spencerh122/CMPE-3815---Microcontroller-Systems-Final-Project/Pictures/Version 2 Electronics Bay.jpeg

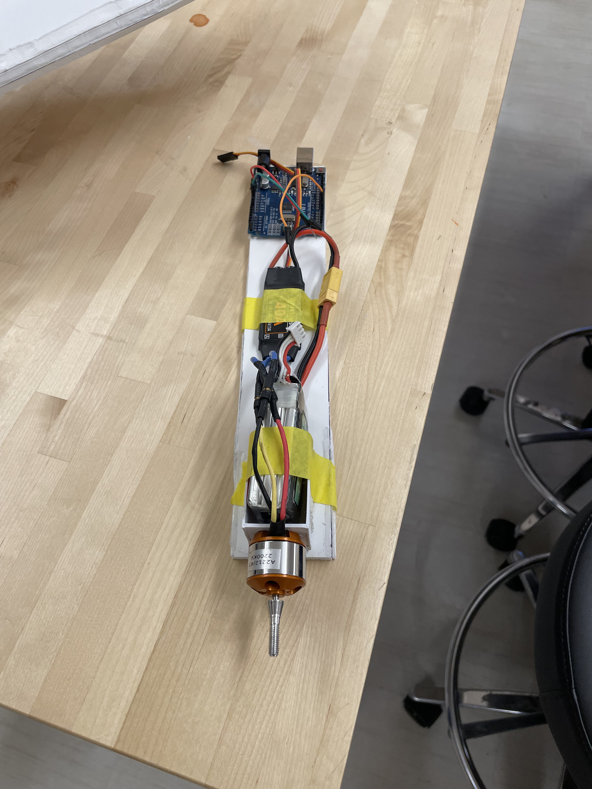
Pictures/Version 2 Electronics Bay.jpeg
