spencerh122/CMPE-3815---Microcontroller-Systems-Final-Project/Pictures/Combustion.jpg

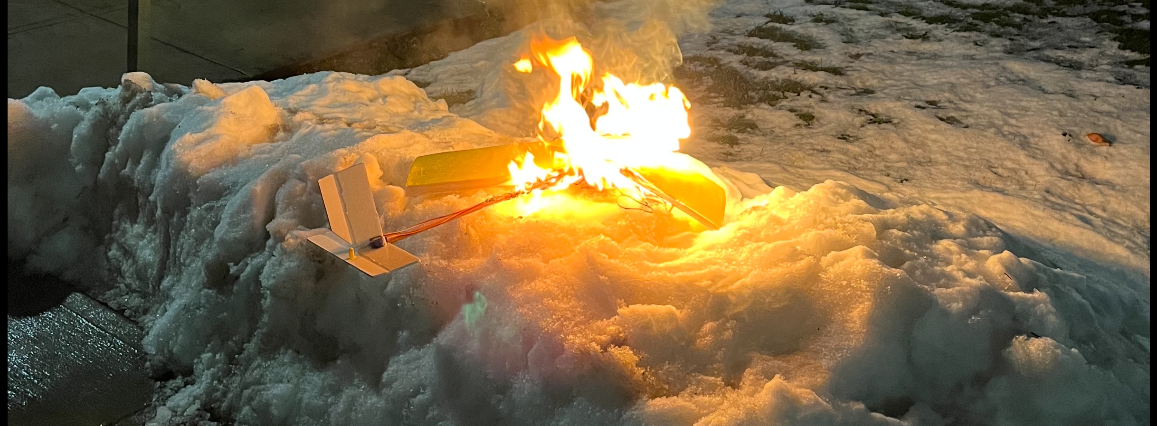
Pictures/Combustion.jpg
