spencerh122/CMPE-3815---Microcontroller-Systems-Final-Project/Pictures/Version 1.jpeg

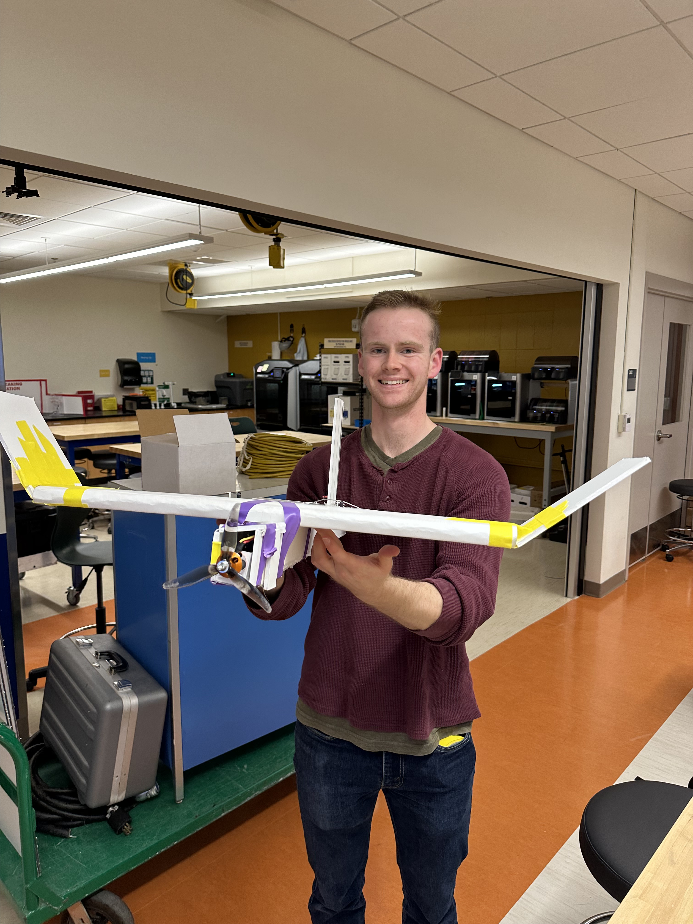
Pictures/Version 1.jpeg
