spencerh122/CMPE-3815---Microcontroller-Systems-Final-Project/Pictures/Version 2.jpeg

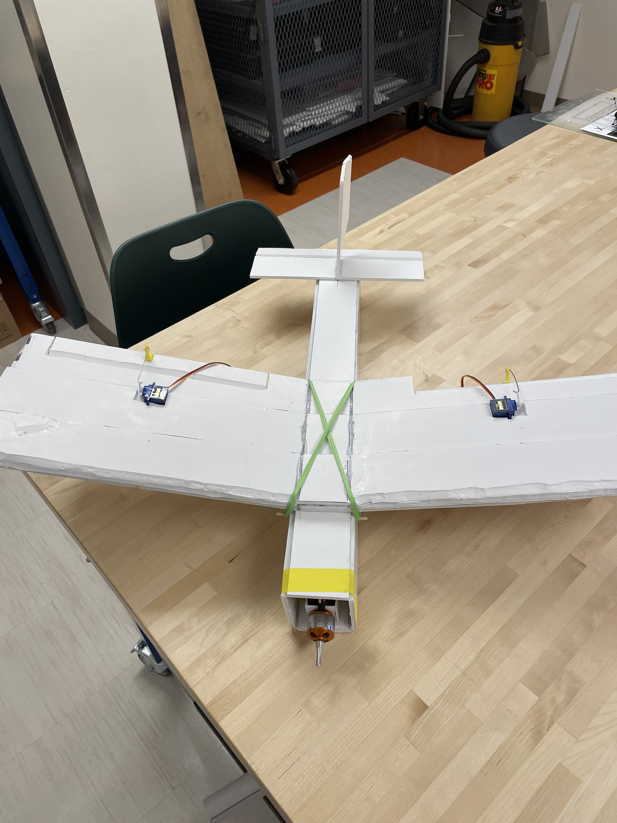
Pictures/Version 2.jpeg
