spencerh122/CMPE-3815---Microcontroller-Systems-Final-Project/Pictures/Version 3.jpeg

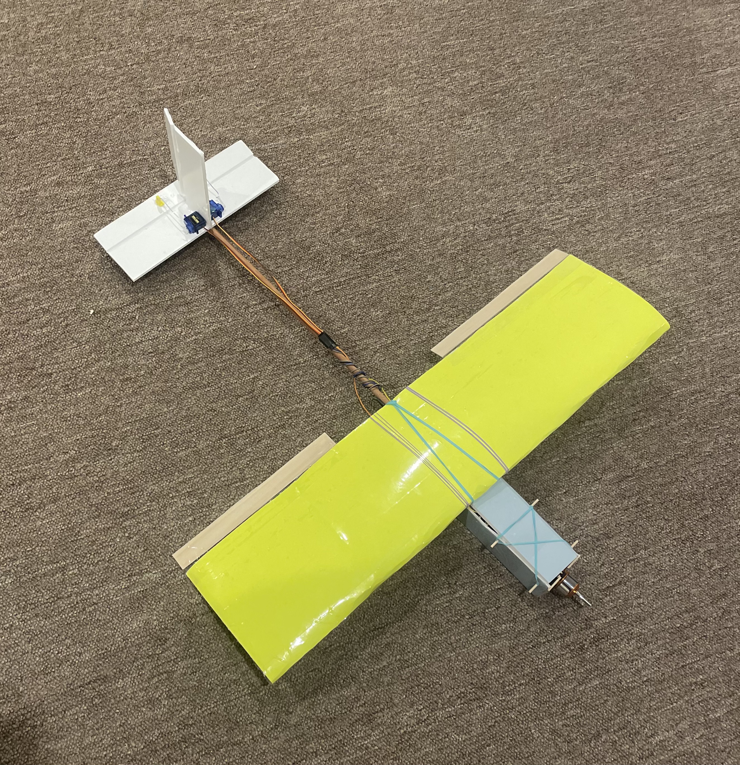
Pictures/Version 3.jpeg
