spencerh122/CMPE-3815---Microcontroller-Systems-Final-Project/Pictures/Version 3 Electronics Bay.jpeg

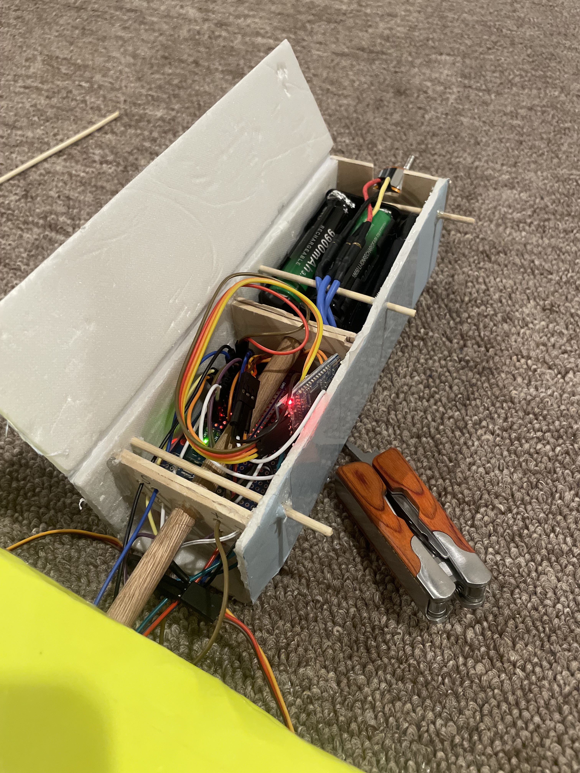
Pictures/Version 3 Electronics Bay.jpeg
